Juliandiazr/Chispas_Reto_Final_Micro/docs/Chispa_Guion_de_sustentacion.docx

# Chispa — Guion de sustentación

Nov 10, 2026 · @Julian David Diaz Ramirez

## Guion

Duración total: unos 7 minutos, repartidos entre los dos integrantes (A y B). Entre corchetes va lo que se hace en la demostración. Antes de empezar: la tarjeta encendida, la terminal abierta y chispa_app.c abierto en CubeIDE.

### 1. Presentación (A, 40 s)

"Buenos días. Nuestro proyecto es Chispa, una mascota virtual que vive en el STM32F407. Tiene hambre, se aburre, se ensucia y se cansa, y reacciona a lo que hacemos con ella. Usamos CubeMX, la HAL de ST y FreeRTOS con cinco tareas."

[Presionar RST: el huevo se bambolea, se agrieta y nace Chispa con la melodía de eclosión.]

"Al arrancar, Chispa está en el estado HUEVO mientras revisa sus sensores. Si todo responde, nace y pasa a NORMAL."

### 2. Funcionamiento y entradas/salidas (B, 1 min 30 s)

"Tiene tres tipos de entrada: pulsadores por interrupción externa, una fotorresistencia por el ADC y un acelerómetro MPU6050 por I²C. Y tres tipos de salida: la pantalla OLED por I²C, un buzzer y un LED RGB, ambos con PWM."

[Presionar Comer: cara comiendo, "NAM NAM", LED naranja, sube la barra H.]

"Cuando la alimentamos, sube su barra de hambre. Si la alimentamos llena, se niega." [Comer otra vez: "NO!".]

[Jugar: "A JUGAR!", LED verde. Limpiar: destellos, LED celeste.]

[Tapar la LDR: a los 1.5 s se duerme, "ZZZ", LED azul. Destapar: despierta.]

"La fotorresistencia detecta si apagamos la luz. El umbral se adapta a la luz del salón, así que funciona de día y de noche."

[Sacudir la protoboard: cara enojada, "GRR!", LED rojo.]

### 3. Estados (A, 45 s)

"Chispa tiene cinco estados: HUEVO, NORMAL, NECESIDAD, DORMIDA y ERROR. Cada 10 segundos pasa una hora para ella y sus barras bajan. Cuando alguna cae por debajo de 30, entra en NECESIDAD: se pone triste, el LED parpadea en amarillo y nos dice qué le falta."

[Mostrar el diagrama de estados del documento técnico o la terminal con LOGICA: estado NORMAL -> NECESIDAD.]

### 4. Arquitectura de tareas (B, 1 min 15 s)

"Dividimos el firmware en cinco tareas con cuatro niveles de prioridad. Sensores y Sonido tienen la más alta, porque si se atrasan se pierde una sacudida o se corta una nota. Lógica tiene prioridad normal: decide qué pasa con cada evento. Pantalla es la más lenta, unos 26 ms por cuadro, y por eso tiene prioridad baja: si se atrasa solo se pierde un cuadro. Log es la más baja."

"Para comunicarlas usamos una cola de eventos hacia Lógica, que reciben la interrupción de los botones y la tarea Sensores; una notificación de tarea para pedir melodías, porque solo se envía un número; una cola de un elemento con overwrite para la pantalla, porque solo importa el dato más reciente; y un mutex que protege el bus I²C, porque la pantalla y el acelerómetro están en el mismo bus."

"Ninguna tarea usa HAL_Delay: todas se bloquean en un retardo, una cola o una notificación, y mientras están bloqueadas no consumen CPU."

### 5. Evidencia de preemption (A, 1 min)

[Presionar Jugar varias veces seguidas mientras se mira la terminal.]

"Aquí se ve la planificación por prioridades. Esta línea dice que la Pantalla estaba enviando un cuadro entre el milisegundo 66 106 y el 66 132. En el 66 123 presionamos el botón. La interrupción puso el evento en la cola, y Lógica y Sonido, que tienen más prioridad, pasaron de bloqueadas a listas y se ejecutaron en ese mismo milisegundo. La Pantalla quedó lista pero sin CPU, y terminó su cuadro después."

### 6. Memoria y estabilidad (B, 40 s)

"Verificamos el stack con uxTaskGetStackHighWaterMark, que reportamos cada 30 segundos. Todas las tareas quedan con más del 35 % libre. En la prueba de estabilidad, Chispa funcionó 13 minutos y 20 segundos seguidos sin reinicios ni errores de memoria."

### 7. Problema técnico resuelto (A, 1 min)

"El problema más difícil fue que Chispa se congelaba después de un rato. En el log vimos que el acelerómetro dejaba de responder justo después de que sonaba el buzzer. El ruido cortaba una transmisión I²C a la mitad y el MPU6050 se quedaba sosteniendo la línea SDA en bajo, así que el bus quedaba bloqueado. Ni el reset lo arreglaba, porque reinicia el micro pero no el sensor."

"Lo resolvimos en hardware, separando y protegiendo la alimentación del buzzer, y en software con una recuperación del bus: el micro da hasta nueve pulsos en SCL para que el sensor suelte la línea y reinicia el I²C. Además, una falla aislada ya no manda a error: solo tres seguidas."

[Opcional: desconectar el MPU6050 → x_x "ERROR SENSOR" → reconectar → se recupera solo.]

### 8. Cierre (B, 20 s)

"En resumen, Chispa cumple los requerimientos del reto: cinco estados, tres tipos de entrada, tres de salida, cinco tareas con cuatro prioridades, colas, notificación y mutex, con evidencia de preemption y más de 13 minutos estable. Muchas gracias, quedamos atentos a sus preguntas."

## Preguntas probables

Pregunta | Respuesta corta
¿Qué diferencia hay entre lista, ejecutándose y bloqueada? | Bloqueada espera algo (retardo, cola, notificación) y no usa CPU; lista ya puede correr pero hay otra de mayor prioridad; ejecutándose es la que tiene la CPU.
¿Por qué una cola y no una variable global? | La cola es segura entre ISR y tareas, guarda varios eventos sin perderlos y despierta a Lógica sin espera activa.
¿Por qué notificación para el sonido? | Solo se envía un número de melodía; la notificación es más rápida y liviana que una cola y permite interrumpir una melodía con otra.
¿Qué protege el mutex? | El bus I²C1, que comparten Pantalla y Sensores. Sin él, dos transmisiones se mezclarían. El mutex tiene herencia de prioridad.
¿Por qué la ISR tiene prioridad 5? | FreeRTOS solo permite llamar sus funciones desde interrupciones con prioridad numérica ≥ 5 (configMAX_SYSCALL_INTERRUPT_PRIORITY).
¿Cómo eliminan el rebote? | En la ISR se ignoran pulsaciones del mismo botón con menos de 200 ms entre ellas.
¿Cómo se genera cada nota? | TIM3 cuenta a 1 MHz; ARR = 10⁶/f − 1 fija la frecuencia y CCR = ARR/2 da 50 % de ciclo útil.
