Juliandiazr/Chispas_Reto_Final_Micro/docs/imagenes/README.md

# Imágenes

| Archivo | Qué muestra |
|---|---|
| `estado_feliz.jpg` | Estado NORMAL, Chispa feliz |
| `accion_comer.jpg` | Botón COMER (PC0): "NAM NAM" |
| `accion_jugar.jpg` | Botón JUGAR (PC1): "A JUGAR!" |
| `accion_limpiar.jpg` | Botón LIMPIAR (PC2): "LIMPIA!" |
| `estado_dormida.jpg` | Estado DORMIDA (botón PC3 o LDR a oscuras) |
| `estado_error_sensor.jpg` | Estado ERROR: "ERROR SENSOR" cuando falla el MPU6050 |
