Juliandiazr/Chispas_Reto_Final_Micro/chispas.ioc

Mcu.UserName=STM32F407VETx
PA1.Signal=ADCx_IN1
PA10.Signal=USART1_RX
PA13.Signal=SYS_JTMS-SWDIO
PA14.Signal=SYS_JTCK-SWCLK
PA9.Signal=USART1_TX
PB0.Signal=S_TIM3_CH3
PB6.Signal=I2C1_SCL
PB7.Signal=I2C1_SDA
PC0.GPIO_Label=BTN_COMER
PC0.Signal=GPXTI0
PC1.GPIO_Label=BTN_JUGAR
PC1.Signal=GPXTI1
PC2.GPIO_Label=BTN_LIMPIAR
PC2.Signal=GPXTI2
PC3.GPIO_Label=BTN_CARICIA
PC3.Signal=GPXTI3
PD12.Signal=S_TIM4_CH1
PD13.Signal=S_TIM4_CH2
PD14.Signal=S_TIM4_CH3
PH0-OSC_IN.Signal=RCC_OSC_IN
PH1-OSC_OUT.Signal=RCC_OSC_OUT
