Juliandiazr/Chispas_Reto_Final_Micro/Core/Inc/main.h

#define BTN_COMER_Pin GPIO_PIN_0
#define BTN_COMER_GPIO_Port GPIOC
#define BTN_COMER_EXTI_IRQn EXTI0_IRQn
#define BTN_JUGAR_Pin GPIO_PIN_1
#define BTN_JUGAR_GPIO_Port GPIOC
#define BTN_JUGAR_EXTI_IRQn EXTI1_IRQn
#define BTN_LIMPIAR_Pin GPIO_PIN_2
#define BTN_LIMPIAR_GPIO_Port GPIOC
#define BTN_LIMPIAR_EXTI_IRQn EXTI2_IRQn
#define BTN_CARICIA_Pin GPIO_PIN_3
#define BTN_CARICIA_GPIO_Port GPIOC
#define BTN_CARICIA_EXTI_IRQn EXTI3_IRQn
