Juliandiazr/Chispas_Reto_Final_Micro/(commit log)

2026-11-11 Proyecto base generado con STM32CubeMX (HAL + FreeRTOS)
    Claude-Session: https://claude.ai/code/session_01NNNdpXazLF5NUFH3kDt56L
2026-11-11 Drivers propios: OLED SSD1306, MPU6050, fuente 5x7 y recuperacion del bus I2C
    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
2026-11-11 Aplicacion Chispa: tareas, colas, mutex I2C y maquina de estados
    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
2026-11-11 Firmware compilado (.hex) para cargar por J-Link o DFU
    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
2026-11-11 Documentacion: documento tecnico, guion, log UART y evidencias
    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
2026-11-11 Fotos de Chispa: estados y acciones en la OLED
    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
